zmkfirmware/zmk-uno/(threads)

Thread 1 (2023-03-26):

Slider switch is difficult to use

joelspadin, 2023-03-26:
The slider switch doesn't extend past the edge of the PCB, so it's a bit hard to adjust. Additionally, the chosen switch is quite stiff and has weak detents, so getting it into the center position is difficult.

joelspadin, 2023-11-05:
> Additionally, the chosen switch is quite stiff

I actually just had the slider completely shear off because of this.

petejohanson, 2023-12-18:
> > Additionally, the chosen switch is quite stiff
>
> I actually just had the slider completely shear off because of this.

Ooof. Let's try to find something better, for sure.

joelspadin, 2023-12-18:
I should also mention that the reset button doesn't work very well either, but the corner of my button looks a bit melted, so that might just be the fault of my soldering.

Slightly larger switches would probably work better. Whatever switch is used on the nRF52/53 DK for the power switch slides easily and falls into its detents nicely. I'm not sure if there's a SP3T/DP3T version of that, but if so, it might not fit where the slider switch currently is. Maybe you could move the slider switch to the area underneath the display so you can fit a larger one, and then put a (not right angle) tactile switch where the slider was?

petejohanson, 2023-12-31:
@joelspadin Thoughts on this one from Alps?

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

See https://tech.alpsalpine.com/e/products/detail/SSSS212901/

It has the advantages of:

* Top slider, so force is more downward into the plastic bosses.
* Shows force required, and shows that the force to get "out" of the middle position is more, so it should be easier to "land" in the middle.

joelspadin, 2023-12-31:
Hard to say without trying one in person, but that looks better to me.

Thread 2 (2023-11-05):

Add jumper/switch to select between I2C and SPI display

joelspadin, 2023-11-05:
Using solder jumpers makes it difficult to switch whether the display pins are connected to I2C or SPI. There isn't a lot of free space left, but it would be nice to have jumper headers or similar so we don't have to break out the soldering iron in order to test different types of displays.

petejohanson, 2023-12-18:
Yeah.. let me think about how best to do this... We'd probably need to add another switching IC like we use for the direct vs matrix wire setup, but for the data lines.

joelspadin, 2023-12-18:
Some things that could work:
- A block of 6 pins with display data in the center, SCL/SDA on one side, and SCK/MOSI on the other, so you can pick which are connected with a pair of jumpers.
    ```
    I2C        SPI
    [o o] o    o [o o]
    [o o] o    o [o o]
    ```
- A DPDT switch to do the same.
- An analog switch IC like you mentioned.
