zmkfirmware/zmk-uno/(commit log)

2021-12-21 Initial work on ZMK Uno.
    [zmk-uno.kicad_pcb, zmk-uno.kicad_sch, zmk-uno.sch]
2021-12-22 feat: routed, silk updates, etc.
    [zmk-uno.kicad_pcb, zmk-uno.kicad_sch]
2021-12-22 Actually route encoder A/B lines
    [zmk-uno.kicad_pcb, zmk-uno.kicad_sch]
2021-12-22 Tweak reset, RGB LEDs.
    [zmk-uno.kicad_pcb, zmk-uno.kicad_sch]
2021-12-22 Proper 2mm spacing for switch pin header rows.
    [zmk-uno.kicad_pcb]
2021-12-22 Move to EL817S1 optocoupler, start of BOM docs.
    [zmk-uno.kicad_pcb, zmk-uno.kicad_sch]
2021-12-23 Schematic cleanup, BOM tweaks.
    [zmk-uno.kicad_sch]
2021-12-29 Routing/placement fixes.
    [zmk-uno.kicad_pcb, zmk-uno.kicad_sch]
2021-12-29 Minor schematic visual clean up.
    [zmk-uno.kicad_sch]
2021-12-29 TRRS jack silk.
    [zmk-uno.kicad_pcb]
2021-12-30 Routing tweaks for new PWM backlight.
    [zmk-uno.kicad_pcb, zmk-uno.kicad_sch]
2021-12-31 Convert arcs to traces.
    [zmk-uno.kicad_pcb]
2022-01-12 Move to new marbastlib.
    [zmk-uno.kicad_pcb, zmk-uno.kicad_sch]
2022-01-12 More minor routing tweaks.
    [zmk-uno.kicad_pcb]
2022-04-24 Major updates, automation for production, etc.
    [zmk-uno.kicad_pcb, zmk-uno.kicad_sch, zmk-uno.sch]
2022-04-28 Fix archive path for position/bom files.
2022-05-13 Silk fixes, SSD wiring fixes, RGB fixes.
    [zmk-uno.kicad_pcb, zmk-uno.kicad_sch]
2022-05-14 Add one wire UART split pull up and jumper, routing tweaks.
    [zmk-uno.kicad_pcb, zmk-uno.kicad_sch]
2022-05-14 Use a couple text variables.
    [zmk-uno.kicad_pcb, zmk-uno.kicad_sch]
2022-05-16 Minor component selection tweaks, add second power domain for LEDs.
    [zmk-uno.kicad_pcb, zmk-uno.kicad_sch]
2022-05-16 Fixes for MOSFETs, updated README.
    [zmk-uno.kicad_pcb, zmk-uno.kicad_sch]
2022-05-19 feat: Add SP3T toggle switch for direct toggle-mode.
    [zmk-uno.kicad_pcb, zmk-uno.kicad_sch]
2022-05-24 Few new components, re-do placement, silk fixes
    * Added reverse mount LEDs as power indicators for the main ext. power
    and LED power sub-domain. There's cut-able pads if you want to disable
    them for power measurements.
    * Moved the i2c pull ups to a solder jumper on the back, this doesn't
    seem like something that needs to be changed like the others.
    * Moved TRRS jack out from under the display. It's just too tight, and
    that placement puts it closer to the relevant jumpers.
    * Moved direct pin jumper closer to the switches, out of the way of the
    TRRS jumper stuff.
    * Better silk w/ URL/QR Code, credits on the back with room to add other
    folks whenever we have folks add to it.
    * Moved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
    [zmk-uno.kicad_pcb, zmk-uno.kicad_sch]
2022-05-25 Add support for sharp displays via a few jumpers.
    [zmk-uno.kicad_pcb, zmk-uno.kicad_sch]
2022-05-25 fix: Don't exclude reverse mount LEDs.
2022-05-25 More routing tweaks.
    [zmk-uno.kicad_pcb, zmk-uno.kicad_sch]
2022-05-25 Minor fixes.
    [zmk-uno.kicad_sch]
2022-05-31 Proper rotation for the switching IC.
2022-05-31 Try again, proper switch IC rotation.
2022-06-13 Updated pics of the board.
2022-06-13 Minor layout tweaks.
    [zmk-uno.kicad_pcb]
2022-06-13 Fix some disconnected ground fill.
    [zmk-uno.kicad_pcb]
2022-06-23 Change stack-up colors to match standard black PCBs.
    [zmk-uno.kicad_pcb]
2023-02-01 fix: Switch to strong pull up for switching IC.
    [zmk-uno.kicad_pcb, zmk-uno.kicad_sch]
2023-12-18 fix: Add multiplexer to README BOM.
